hakangoktug-torun/ELE495-Autonomous-Basketball-Robot/media/urun_son.jpeg

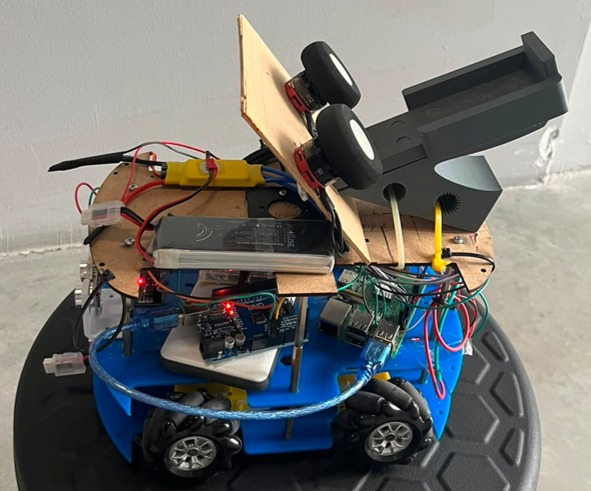
media/urun_son.jpeg
