hakangoktug-torun/ELE495-Autonomous-Basketball-Robot/software/raspberry_pi/kalibrasyon_kodlari/test_surus.py

"""
ELE495 - Test Surusu (KARE rota)
Senaryo:
  1) Bir cisim 30 cm'ye kadar yaklasana kadar duz git (1. kenar)
  2) 90 derece sola don (kapali dongu, BNO055 ile)
  3) Bir cisim 30 cm'ye kadar yaklasana kadar duz git (2. kenar)
  4) 90 derece sola don
  5) Bir cisim 30 cm'ye kadar yaklasana kadar duz git (3. kenar)
  6) 90 derece sola don
  7) Bir cisim 30 cm'ye kadar yaklasana kadar duz git (4. kenar)
  8) 90 derece sola don (kareyi tamamlar, robot baslangictaki yone bakar)
  9) Dur

Toplam: 4 kenar + 4 donus = tam bir kare rota, 360 derece toplam donus.

GUNCELLEME (acil durdur destegi): guvenli_donus(), ileri_git_sabit_mesafe()
ve ileri_git_engel_bulunca() artik opsiyonel bir dur_bayragi (threading.Event)
parametresi aliyor. Set edilirse motoru en kisa surede durdurup fonksiyondan
cikarlar - Acil Durdur / Ctrl+C icin kullanilir.

GUNCELLEME (BU SURUM - "hayalet mesafe sicramasi" duzeltmesi):
  ileri_git_engel_bulunca()'da fiziksel olarak IMKANSIZ ani mesafe
  dususleri (orn. 66cm -> 23cm tek ornekte, iki ornek arasindaki ~30-50ms'de
  robotun bu hizda asla kat edemeyecegi bir mesafe) artik dogrudan kabul
  edilmiyor. Bu, ultrasonik sensorun acili yuzeyden/gurultuden kaynakli
  YANLIS bir yankiyi (multipath) GERCEK bir yaklasma sanip, robotu hedeften
  onemli olcude ONCE durdurmasina yol aciyordu (gozlemlendi: hedef 49cm,
  robot 25cm'de durdu). Su an bir sicrama sadece BIR SONRAKI ornek de
  benzer bir deger verirse (yani robot gercekten oraya ulasmissa) kabul
  ediliyor - aksi halde tamamen yoksayilip bir sonraki gercek olcum
  beklenir (bkz. donus_hassas.py'deki HeadingTakip sicrama filtresiyle
  AYNI mantik, burada mesafe icin uygulandi).

Bu dosyayi ayni klasore koy: software/raspberry_pi/kalibrasyon_kodlari/
(donus_kapali_dongu.py ve robot_bridge.py ile ayni yerde olmali)

ONEMLI VARSAYIM: Duz ileri gitme icin motor yon pinlerini tahmin ederek yazdim
(IN1=HIGH,IN2=LOW ve IN3=HIGH,IN4=LOW seklinde - donus kodundaki 'her iki motor
ayni sinyali alir' mantigina ters, cunku duz gitmede motorlar TERS yonde
komutlanmali - fiziksel montaj karsilikli oldugu icin). Eger robot ilk testte
GERI giderse, ILERI_IN_PATTERN degiskenini asagida ters cevir.
"""

import sys
import os
import time
import RPi.GPIO as GPIO

sys.path.append(os.path.join(os.path.dirname(__file__), ".."))
from robot_bridge import RobotBridge
from donus_kapali_dongu import (
    donus_yap, motorlari_ayarla, motorlari_durdur, aci_farki, isinma_yap,
    IN1, IN2, IN3, IN4, ENA, ENB, SERIAL_PORT
)

# ---------- Duz gitme kapali dongu duzeltme ayarlari ----------
DUZELTME_KAZANCI = 0.4    # (P) derece basina duty duzeltme miktari
DUZELTME_KAZANCI_I = 0.03  # (I) kalici/sabit asimetriyi (motor farki) zamanla sifirlamak icin
                             # (0.08'den 0.03'e dusuruldu - integral terimi hatayi zamanla
                             # biriktirip asiri duzeltmeye/erken rota kaymasina yol acabiliyordu)
MAKS_DUZELTME = 10.0      # duty cinsinden - toplam (P+I) duzeltmenin ustsiniri
MAKS_INTEGRAL = 15.0      # integral birikiminin kendi ustsiniri (anti-windup)

# ---------- Duz gitme hiz/kalibrasyon ayarlari ----------
# GUNCELLEME: 6V motor / 11.1V (3S) pil uyumsuzlugu nedeniyle dusuk duty'lerde
# motorlar marjinal/yetersiz tork bolgesinde kaliyordu - rastgele teker
# tutuklugunun asil sebebiydi. Atici (ESC+ucus motorlari) eklenince ek yuk/
# elektriksel gurultu bindigi icin tekerler yine bazen yetersiz kalip stall'a
# girmeye basladi - 1.2x yetersiz kaldigi icin 1.4x'e, sonra sag donuste asma/
# sag arka teker tutuklugu devam ettigi icin 1.5x'e cikarildi.
# ONEMLI: CM_PER_SANIYE artik hafifce GECERSIZ olabilir - hiz degistigi icin
# yeniden kalibre edilmesi gerekebilir (ileri_git_sabit_mesafe kullanan yerlerde).
SOL_HIZ = 38
SAG_HIZ = 42
CM_PER_SANIYE = 23.5  # UYARI: bu deger eski hiz icin kalibre edilmisti, hafif hatali olabilir

ENGEL_ESIGI_CM = 30.0     # bu mesafenin altina inince dur

# Vcc (5V hatti gerilimi) takibi - guc yetersizligi teshisi icin. Test
# boyunca gorulen en dusuk degeri saklar, sonunda ozet olarak yazdirilir.
VCC_TAKIP = {"en_dusuk": None, "dusuk_gerilim_esigi": 4300, "uyari_verildi": False}


def _durdurma_istendi_mi(dur_bayragi):
    """Ortak yardimci - dur_bayragi verilmis ve set edilmisse True doner."""
    return dur_bayragi is not None and dur_bayragi.is_set()


def vcc_kontrol_et(vcc_mv):
    """Vcc degerini VCC_TAKIP'e kaydeder, dusuk gerilimde bir kez uyarir."""
    if vcc_mv is None:
        return
    if VCC_TAKIP["en_dusuk"] is None or vcc_mv < VCC_TAKIP["en_dusuk"]:
        VCC_TAKIP["en_dusuk"] = vcc_mv
    if vcc_mv < VCC_TAKIP["dusuk_gerilim_esigi"] and not VCC_TAKIP["uyari_verildi"]:
        print(f"  [UYARI] DUSUK GERILIM tespit edildi: {vcc_mv:.0f}mV "
              f"(esik: {VCC_TAKIP['dusuk_gerilim_esigi']}mV) - guc kaynagi "
              f"yetersiz kalabilir.")
        VCC_TAKIP["uyari_verildi"] = True
YAVASLAMA_MESAFE_FARKI = 22.5  # esige bu kadar cm kala yavasla (1. kademe) (21'den 22.5'e - 1.5x)
HIZ_YAVAS_ENGEL = 33       # 1. kademe yavaslama hizi (31'den 33'e - 1.5x)
COK_YAVAS_MESAFE_FARKI = 7.5   # esige bu kadar cm kala IYICE yavasla (2. kademe) (7'den 7.5'e - 1.5x)
HIZ_COK_YAVAS_ENGEL = 30   # 2. kademe (son yaklasim) hizi (28'den 30'a - 1.5x)
ILERI_ADIM_CM = 20.0      # her iki donusten sonra gidilecek mesafe
MAKS_ENGEL_BEKLEME = 20.0  # saniye - engel hic bulunamazsa guvenlik siniri


def ileri_yon_ayarla():
    """
    VARSAYIM: Duz ileri gitme icin motor pinleri. Donus kodunda (donus_yonu_ayarla)
    'sol' icin IN1=LOW,IN2=HIGH ve IN3=LOW,IN4=HIGH kullanilmisti (ikisi ayni yonde
    komutlanip robotu DONDURUYORDU). Duz gitmek icin motorlarin TERS yonde
    komutlanmasi gerekiyor (fiziksel montaj karsilikli oldugundan), yani:
      Motor A (IN1,IN2): HIGH,LOW
      Motor B (IN3,IN4): LOW,HIGH  <-- Motor A'nin tam tersi

    Eger robot geri giderse ya da donerse, asagidaki iki satiri birbiriyle
    degistirerek dene.
    """
    GPIO.output(IN1, GPIO.HIGH); GPIO.output(IN2, GPIO.LOW)
    GPIO.output(IN3, GPIO.LOW);  GPIO.output(IN4, GPIO.HIGH)


def geri_yon_ayarla():
    """
    YENI: Duz GERIYE gitme icin motor pinleri - ileri_yon_ayarla()'nin
    TAM TERSI (IN pinleri ters cevrilmis). GECISLER listesinde "sure"
    hareket tipine "yon": "geri" eklenince (bkz. ileri_git_sabit_sure'daki
    yon parametresi) bu fonksiyon kullanilir.
    """
    GPIO.output(IN1, GPIO.LOW);  GPIO.output(IN2, GPIO.HIGH)
    GPIO.output(IN3, GPIO.HIGH); GPIO.output(IN4, GPIO.LOW)


def ileri_git_sabit_mesafe(pwm_a, pwm_b, mesafe_cm, bridge=None, dur_bayragi=None):
    """
    Sabit mesafe ileri gider. bridge verilirse, BNO055 heading feedback ile
    sapmayi (saga/sola kayma) anlik olarak duzeltir - bridge verilmezse
    eskisi gibi acik dongu (duzeltmesiz) calisir.

    dur_bayragi: (YENI) set edilirse hareket en kisa surede durdurulup
    fonksiyondan cikilir.
    """
    sure = mesafe_cm / CM_PER_SANIYE
    print(f"Ileri gidiliyor: {mesafe_cm} cm (~{sure:.2f}s)")

    if _durdurma_istendi_mi(dur_bayragi):
        print("DURDURMA sinyali - ileri gitme baslamadan iptal edildi.")
        return

    ileri_yon_ayarla()

    if bridge is None:
        pwm_a.ChangeDutyCycle(SOL_HIZ)
        pwm_b.ChangeDutyCycle(SAG_HIZ)
        baslangic = time.time()
        while time.time() - baslangic < sure:
            if _durdurma_istendi_mi(dur_bayragi):
                print("DURDURMA sinyali - ileri gitme (acik dongu) iptal ediliyor.")
                break
            time.sleep(0.03)
        motorlari_durdur(pwm_a, pwm_b)
        return

    # ---- Kapali dongu: hedef heading'i koru (PI kontrolor) ----
    hedef_heading = bridge.get_heading()
    print(f"  [DEBUG] Hedef heading: {hedef_heading}")
    baslangic = time.time()
    adim_sayaci = 0
    integral = 0.0
    son_zaman = baslangic

    while time.time() - baslangic < sure:
        if _durdurma_istendi_mi(dur_bayragi):
            print("DURDURMA sinyali - ileri gitme (kapali dongu) iptal ediliyor.")
            break

        simdiki_heading = bridge.get_heading()
        simdi = time.time()
        dt = simdi - son_zaman
        son_zaman = simdi

        if simdiki_heading is not None and hedef_heading is not None:
            # Pozitif hata: heading artmis (robot 'sag'a donmus) -> bunu duzeltmek icin
            # sola kivrilmali -> sol tekeri YAVASLAT, sag tekeri HIZLANDIR
            # Negatif hata: heading azalmis (robot 'sol'a donmus) -> tam tersi
            hata = aci_farki(hedef_heading, simdiki_heading)

            integral += hata * dt
            integral = max(-MAKS_INTEGRAL, min(MAKS_INTEGRAL, integral))  # anti-windup

            duzeltme = DUZELTME_KAZANCI * hata + DUZELTME_KAZANCI_I * integral
            duzeltme = max(-MAKS_DUZELTME, min(MAKS_DUZELTME, duzeltme))

            sol_duty = max(0, min(100, SOL_HIZ - duzeltme))
            sag_duty = max(0, min(100, SAG_HIZ + duzeltme))

            pwm_a.ChangeDutyCycle(sol_duty)
            pwm_b.ChangeDutyCycle(sag_duty)
        else:
            sol_duty, sag_duty = SOL_HIZ, SAG_HIZ
            pwm_a.ChangeDutyCycle(SOL_HIZ)
            pwm_b.ChangeDutyCycle(SAG_HIZ)

        if adim_sayaci % 3 == 0:  # her ~150ms'de bir goster, ekrani doldurmasin
            print(f"  [DEBUG] heading={simdiki_heading} sol_duty={sol_duty:.1f} sag_duty={sag_duty:.1f}")
        adim_sayaci += 1

        time.sleep(0.05)

    motorlari_durdur(pwm_a, pwm_b)
    print(f"  [DEBUG] Ileri gitme tamamlandi, toplam {adim_sayaci} adim calisti.")


def ileri_git_engel_bulunca(bridge, pwm_a, pwm_b, esik_cm=ENGEL_ESIGI_CM,
                              maks_sure=MAKS_ENGEL_BEKLEME, dur_bayragi=None,
                              hiz_carpani=1.0):
    """
    Bir cisim esik_cm mesafesine kadar yaklasana kadar duz gider.
    Esige iki kademeli yavaslama uygulanir (once YAVASLAMA_MESAFE_FARKI,
    sonra COK_YAVAS_MESAFE_FARKI kala) - boylece durma ani daha hassas olur,
    overshoot (esigi fazla gecme) azalir. Ayrica BNO055 heading feedback ile
    saga/sola kaymayi (drift) anlik olarak duzeltir.

    hiz_carpani: (YENI) taban hizi (SOL_HIZ/SAG_HIZ) bu katsayiyla carpar -
    SADECE bu cagriya ozel, global SOL_HIZ/SAG_HIZ SABIT kalir (diger
    kullanimlari etkilemez). Ornegin hiz_carpani=1.3/1.5 ile, global
    hizlar 1.5x kalibrasyonuna gore ayarlanmisken bu YOL ozelinde 1.3x'e
    dusurulmus olur. 1.0 = degisiklik yok (varsayilan).

    dur_bayragi: (YENI) set edilirse hareket en kisa surede durdurulup
    False donulur (engel bulunamamis gibi - cagiran kod zaten bunu guvenli
    bir durus olarak isliyor).

    ONEMLI: Ultrasonik sensor (HC-SR04) acili yuzeylerden/duvar koselerinden
    yansiyinca (multipath) tek seferlik, gercek olmayan yakin mesafe okumalari
    verebilir. Bunu filtrelemek icin iki AYRI mekanizma var:
      1) Sadece GERCEKTEN YENI gelen Arduino orneklerini sayiyoruz (bridge'in
         ic 'last_update' zaman damgasina bakarak) - ayni bayat degeri hizli
         polling yuzunden birden fazla kez okumus olmak, "dogrulanmis ardisik
         okuma" sayilmiyor.
      2) (YENI) FIZIKSEL OLABILIRLIK FILTRESI: iki ornek arasinda robotun bu
         hizda ASLA kat edemeyecegi kadar BUYUK ve ANI bir mesafe DUSUSU
         (orn. 66cm -> 23cm tek ornekte) dogrudan kabul edilmez - byle bir
         sicrama, BIR SONRAKI ornek de benzer bir deger vermezse tamamen
         yoksayilir (donus_hassas.py'deki heading sicrama filtresiyle AYNI
         mantik, burada mesafe icin). Bu, sensorun yanlis/erken bir yankiyi
         gercek bir yaklasma sanip robotu hedeften COK ONCE durdurmasini
         (gozlemlenen bir sorun) engeller.
    """
    print(f"Engel araniyor (esik: {esik_cm} cm, hiz carpani: {hiz_carpani:.3f})...")

    if _durdurma_istendi_mi(dur_bayragi):
        print("DURDURMA sinyali - engel aramaya baslamadan iptal edildi.")
        return False

    ileri_yon_ayarla()

    hedef_heading = bridge.get_heading()  # duz gitmeyi korumak icin referans yon

    temel_sol, temel_sag = SOL_HIZ * hiz_carpani, SAG_HIZ * hiz_carpani
    pwm_a.ChangeDutyCycle(temel_sol)
    pwm_b.ChangeDutyCycle(temel_sag)

    yavas_moda_gecildi = False
    cok_yavas_moda_gecildi = False
    ardisik_esik_alti = 0
    GEREKEN_ARDISIK_OKUMA = 3
    son_islenen_zaman_damgasi = None
    integral = 0.0
    son_zaman = time.time()

    # STALL tespiti: yavaslama asamasinda mesafe uzun sure hic degismezse,
    # robot dusuk duty'de fiziksel olarak durmus (stall) demektir - donus
    # testlerinde ayni sorunu yasamistik. Boyle bir durumda kisa bir sure
    # icin tam hiza cikip 'kurtarma' (unstick) yapariz.
    STALL_ESIGI = 1.0  # saniye - mesafe bu sure degismezse stall say (artik tum hiz modlarinda)
    KURTARMA_SURESI = 0.15  # saniye - kurtarma icin tam hizda kalinacak sure
    MAKS_ARDISIK_KURTARMA = 5  # bu kadar ardisik kurtarma basarisiz olursa vazgec, guvenlik amacli dur
    ardisik_basarisiz_kurtarma = 0
    son_mesafe_degeri = None
    son_mesafe_degisim_zamani = time.time()

    # ---- YENI: Fiziksel olabilirlik filtresi (multipath/gurultu korumasi) ----
    # son_gecerli_mesafe: en son KABUL EDILEN (gercek sayilan) mesafe olcumu.
    # bekleyen_supheli_mesafe: suphelenilen ama henuz DOGRULANMAMIS bir
    #   sicrama degeri - bir sonraki ornek buna yakin cikarsa gercek sayilir.
    # MAKS_GECERLI_MESAFE_SICRAMASI: bir ornekten digerine (yaklasik 30-50ms
    #   arayla) bu kadar cm'den BUYUK bir ANI DUSUS, robotun bu hizda
    #   fiziksel olarak kat edemeyecegi bir mesafedir - supheli sayilir.
    son_gecerli_mesafe = None
    bekleyen_supheli_mesafe = None
    MAKS_GECERLI_MESAFE_SICRAMASI = 15.0  # cm

    baslangic = time.time()
    while time.time() - baslangic < maks_sure:
        if _durdurma_istendi_mi(dur_bayragi):
            motorlari_durdur(pwm_a, pwm_b)
            print("DURDURMA sinyali - engel arama dongusu iptal ediliyor.")
            return False

        if bridge.is_stale(max_age_sec=0.5):
            time.sleep(0.03)
            continue

        veri = bridge.get_all()
        mesafe = veri["distance"]
        simdiki_heading = veri["heading"]
        guncel_zaman_damgasi = veri["last_update"]

        simdi = time.time()
        dt = simdi - son_zaman
        son_zaman = simdi

        # ---- Heading feedback ile saga/sola kaymayi duzelt (PI kontrolor) ----
        if simdiki_heading is not None and hedef_heading is not None:
            hata = aci_farki(hedef_heading, simdiki_heading)

            integral += hata * dt
            integral = max(-MAKS_INTEGRAL, min(MAKS_INTEGRAL, integral))  # anti-windup

            duzeltme = DUZELTME_KAZANCI * hata + DUZELTME_KAZANCI_I * integral
            duzeltme = max(-MAKS_DUZELTME, min(MAKS_DUZELTME, duzeltme))
        else:
            duzeltme = 0.0

        sol_duty = max(0, min(100, temel_sol - duzeltme))
        sag_duty = max(0, min(100, temel_sag + duzeltme))
        pwm_a.ChangeDutyCycle(sol_duty)
        pwm_b.ChangeDutyCycle(sag_duty)

        # Bu, bir onceki kontrolden beri gelen GERCEKTEN YENI bir ornek mi?
        yeni_ornek_mi = (son_islenen_zaman_damgasi is None or
                         guncel_zaman_damgasi != son_islenen_zaman_damgasi)

        if yeni_ornek_mi and mesafe is not None and mesafe > 0:  # -1 = gecersiz okuma, yoksay
            son_islenen_zaman_damgasi = guncel_zaman_damgasi

            # ---- Fiziksel olabilirlik filtresi (multipath/gurultu korumasi) ----
            # Ani ve BUYUK bir mesafe dususu (orn. 66cm -> 23cm tek ornekte),
            # robotun bu hizda fiziksel olarak kat edemeyecegi bir degisimdir.
            # Boyle bir sicrama, bir SONRAKI ornekte DE benzer bir deger
            # vermezse GERCEK sayilmaz ve tamamen yoksayilir.
            if (son_gecerli_mesafe is not None and
                    (son_gecerli_mesafe - mesafe) > MAKS_GECERLI_MESAFE_SICRAMASI):
                if bekleyen_supheli_mesafe is not None and abs(mesafe - bekleyen_supheli_mesafe) <= 3.0:
                    print(f"  (Mesafe sicramasi DOGRULANDI, gercek kabul edildi: {mesafe:.1f} cm)")
                    bekleyen_supheli_mesafe = None
                else:
                    print(f"  (SUPHELI mesafe sicramasi gorzmezden gelindi: "
                          f"{son_gecerli_mesafe:.1f}cm -> {mesafe:.1f}cm - "
                          f"bir sonraki ornekte dogrulanirsa kabul edilecek)")
                    bekleyen_supheli_mesafe = mesafe
                    time.sleep(0.03)
                    continue
            son_gecerli_mesafe = mesafe

            print(f"  Mesafe: {mesafe:.1f} cm")
            vcc_kontrol_et(veri.get("vcc_mv"))

            # STALL tespiti: HANGI hiz modunda olursa olsun (tam hiz dahil),
            # mesafe STALL_ESIGI suresi boyunca hic degismediyse, robot
            # fiziksel olarak durmus demektir. Kisa bir 'kurtarma' atisi yap.
            # ONCEKI SURUM sadece yavas modlarda kontrol ediyordu - bu da tam
            # hizdayken olusan tam stall'lari (hicbir tekerin donmedigi durum)
            # kacirmasina yol aciyordu.
            if son_mesafe_degeri is None or abs(mesafe - son_mesafe_degeri) >= 1.0:
                son_mesafe_degeri = mesafe
                son_mesafe_degisim_zamani = time.time()
                ardisik_basarisiz_kurtarma = 0
            elif (time.time() - son_mesafe_degisim_zamani > STALL_ESIGI and
                  mesafe > esik_cm):
                ardisik_basarisiz_kurtarma += 1
                print(f"  (STALL tespit edildi - {mesafe:.1f} cm'de takili kaldi, "
                      f"kurtarma atisi yapiliyor... [{ardisik_basarisiz_kurtarma}/{MAKS_ARDISIK_KURTARMA}])")

                if ardisik_basarisiz_kurtarma > MAKS_ARDISIK_KURTARMA:
                    print(f"  HATA: {MAKS_ARDISIK_KURTARMA} kurtarma denemesi de basarisiz oldu - "
                          f"robot gercekten hareket etmiyor. Muhtemelen fiziksel bir baglanti "
                          f"sorunu (motor/kablo/L298N). Guvenlik amacli durduruluyor.")
                    motorlari_durdur(pwm_a, pwm_b)
                    return False

                # GUNCELLEME: Son yaklasim fazinda (cok_yavas_moda_gecildi)
                # TAM HIZLI kurtarma atisi (SOL_HIZ/SAG_HIZ) tehlikeli -
                # hedefe cok yakinken ani bir tam-hiz sicramasi, mesafeyi
                # gercekte 'takilma' olmadigi halde ciddi olcude asirabilir
                # (overshoot). Bu asamada zaten dogal olarak cok yavas/az
                # hareket beklenir - bu yuzden daha hafif bir kurtarma
                # (HIZ_YAVAS_ENGEL, daha kisa sure) kullaniyoruz. Sadece
                # hala uzaktayken (henuz cok_yavas_moda_gecildi degilken)
                # gercekten guclu bir "unstick" gerekebilir - orada eskisi
                # gibi tam hiz kullanilmaya devam ediyor.
                if cok_yavas_moda_gecildi:
                    kurtarma_sol, kurtarma_sag = HIZ_YAVAS_ENGEL, HIZ_YAVAS_ENGEL + (SAG_HIZ - SOL_HIZ)
                    kurtarma_suresi_efektif = KURTARMA_SURESI * 0.5
                else:
                    kurtarma_sol, kurtarma_sag = SOL_HIZ * hiz_carpani, SAG_HIZ * hiz_carpani
                    kurtarma_suresi_efektif = KURTARMA_SURESI

                pwm_a.ChangeDutyCycle(kurtarma_sol)
                pwm_b.ChangeDutyCycle(kurtarma_sag)
                time.sleep(kurtarma_suresi_efektif)
                # Kurtarma sonrasi kaldigi yavaslama moduna geri don
                pwm_a.ChangeDutyCycle(temel_sol)
                pwm_b.ChangeDutyCycle(temel_sag)
                son_mesafe_degisim_zamani = time.time()  # sayaci sifirla


            # 2. kademe: esige iyice yaklasinca daha da yavasla (once kontrol
            # edilmeli, cunku 2. kademe esigi 1. kademe esiginin icinde kalir)
            if not cok_yavas_moda_gecildi and mesafe <= (esik_cm + COK_YAVAS_MESAFE_FARKI):
                temel_sol, temel_sag = HIZ_COK_YAVAS_ENGEL, HIZ_COK_YAVAS_ENGEL + (SAG_HIZ - SOL_HIZ)
                cok_yavas_moda_gecildi = True
                yavas_moda_gecildi = True  # 1. kademeyi de gecmis sayilir
                print(f"  (Son yaklasim - iyice yavaslandi: {mesafe:.1f} cm)")
            # 1. kademe: esige yaklasinca yavasla
            elif not yavas_moda_gecildi and mesafe <= (esik_cm + YAVASLAMA_MESAFE_FARKI):
                temel_sol, temel_sag = HIZ_YAVAS_ENGEL, HIZ_YAVAS_ENGEL + (SAG_HIZ - SOL_HIZ)
                yavas_moda_gecildi = True
                print(f"  (Yavaslama bolgesine girildi: {mesafe:.1f} cm)")

            if mesafe <= esik_cm:
                ardisik_esik_alti += 1
                if ardisik_esik_alti >= GEREKEN_ARDISIK_OKUMA:
                    motorlari_durdur(pwm_a, pwm_b)
                    print(f"Engel tespit edildi ({mesafe:.1f} cm), duruldu.")
                    return True
            else:
                ardisik_esik_alti = 0

        time.sleep(0.03)  # daha sik ornekleme, tepki suresini kisaltir

    motorlari_durdur(pwm_a, pwm_b)
    print("UYARI: Zaman asimi, engel bulunamadi. Guvenlik amacli durduruldu.")
    return False


def guvenli_donus(hedef_derece, yon, bridge, pwm_a, pwm_b, maks_deneme=2, dur_bayragi=None):
    """
    donus_yap()'i cagirir, ama sonucu KONTROL EDER. Eger donus BNO055
    kilitlenmesi ya da baska bir sorun yuzunden basarisiz olduysa (donen
    aci, hedefin cok altindaysa - orn. yarisindan az), bunu sessizce
    gecmez: uyari basar ve tekrar dener. Tum denemeler basarisiz olursa,
    False donup testin guvenli sekilde durmasini saglar.

    dur_bayragi: (YENI) set edilirse HICBIR tekrar denemesi yapilmadan
    hemen False doner (donus_yap zaten mevcut donusu de aninda iptal eder).

    Donus deger: True (basarili) / False (tum denemeler basarisiz)
    """
    for deneme in range(1, maks_deneme + 1):
        if _durdurma_istendi_mi(dur_bayragi):
            print("DURDURMA sinyali - donus denemesi yapilmadan iptal edildi.")
            return False

        sonuc = donus_yap(hedef_derece, yon=yon, bridge=bridge, pwm_a=pwm_a, pwm_b=pwm_b,
                           otonom=True, dur_bayragi=dur_bayragi)

        # Basari kontrolu: donen aci, hedefin en az yarisi kadar olmali.
        # Kilitlenme durumunda donus_yap 0.0 (ya da cok kucuk bir deger) doner.
        if abs(sonuc) >= hedef_derece * 0.5:
            return True

        if _durdurma_istendi_mi(dur_bayragi):
            # Basarisizlik durdurma sinyalinden kaynaklandi - tekrar denemeye gerek yok
            return False

        print(f"\nUYARI: Donus basarisiz gorunuyor (istenen {hedef_derece}, "
              f"gerceklesen {sonuc:.1f}). Deneme {deneme}/{maks_deneme}.")

        if deneme < maks_deneme:
            print("Tekrar deneniyor...\n")
            time.sleep(1.0)  # sensorun toparlanmasi icin kisa bir bekleme

    print(f"\nHATA: {maks_deneme} denemede de donus basarili olamadi. "
          f"Test guvenlik amacli durduruluyor.")
    print("Onerilen adimlar: BNO055 baglantisini/montajini kontrol et, "
          "titresim/EMI kaynaklarini gozden gecir.")
    return False


def kucuk_aci_test_ve_ana_donus(bridge, pwm_a, pwm_b, hedef_no, kucuk_aci=20.0, ana_aci=90.0):
    """
    Once KUCUK bir aci testi yapar (saga kucuk_aci kadar don, sonra ayni
    miktarda sola geri don - yani net olarak yerinde kalmasi beklenir),
    sonra normal ANA donusu (sola ana_aci) yapar.

    Bu, kucuk acili donuslerin (ozellikle 'tek/iki teker dönmeme' sorununun
    kucuk acilarda da yasanip yasanmadigini) test etmek icin eklendi.

    Donus deger: True (hepsi basarili) / False (herhangi biri basarisiz)
    """
    print(f"\n=== {hedef_no}. HEDEF - KUCUK ACI TESTI ===")
    print(f"Once saga {kucuk_aci} derece donuluyor (test)...")
    if not guvenli_donus(kucuk_aci, "sag", bridge, pwm_a, pwm_b):
        print(f"Kucuk aci testi (saga {kucuk_aci} derece) basarisiz oldu.")
        return False

    print(f"Simdi sola {kucuk_aci} derece donup baslangic yonune donuluyor...")
    if not guvenli_donus(kucuk_aci, "sol", bridge, pwm_a, pwm_b):
        print(f"Kucuk aci testi (geri donus, sola {kucuk_aci} derece) basarisiz oldu.")
        return False

    print(f"\n=== {hedef_no}. DONUS: {ana_aci} derece sola (ana donus) ===")
    if not guvenli_donus(ana_aci, "sol", bridge, pwm_a, pwm_b):
        print(f"{hedef_no}. ana donus basarisiz oldu.")
        return False

    return True


def main():
    bridge = RobotBridge(port=SERIAL_PORT)
    bridge.start()

    print("BNO055/RobotBridge baglantisi bekleniyor...")
    for _ in range(50):
        if not bridge.is_stale(max_age_sec=1.0):
            break
        time.sleep(0.1)

    if bridge.is_stale(max_age_sec=1.0):
        print("UYARI: Sensor veri akisi yok, baglantiyi kontrol et.")
        bridge.stop()
        return

    # HIZLI MOD: renk sensoru okumasini bastan kapatiyoruz - bu, hem
    # donuslerde hem duz gitmede (mesafe durma kararinda) heading/mesafe
    # verisinin cok daha guncel gelmesini saglar. Bu test scriptinde renk
    # verisi zaten kullanilmiyor.
    bridge.request_fast_mode()
    time.sleep(0.1)

    # PWM nesnelerini BIR KEZ olustur, tum test boyunca (donus + duz gitme)
    # ayni nesneleri kullan. RPi.GPIO'nun ayni pinde ust uste PWM
    # olusturma/yikma sirasinda bazen motoru tepkisiz birakmasi sorununu onler.
    pwm_a, pwm_b = motorlari_ayarla()

    # NOT: Otomatik isinma hareketi (kucuk sallanma) KALDIRILDI. EEPROM'dan
    # kalibrasyon zaten yukleniyor ve hizli mod (renk sensoru kapali) veri
    # kalitesini onemli olcude arttirdigi icin, bu hareketin sagladigi kucuk
    # fayda (mag kalibrasyonuna hafif katki), robotun baslangic yonunde
    # istenmeyen kaymaya yol acma riskine degmiyor. Gerekirse yeniden
    # aktiflestirmek icin: isinma_yap(bridge, pwm_a, pwm_b)

    try:
        # ---- 1) Engele kadar duz git ----
        bulundu = ileri_git_engel_bulunca(bridge, pwm_a, pwm_b)

        if not bulundu:
            print("Engel bulunamadigi icin test durduruldu.")
            return

        # ---- 2) Kucuk aci testi + 90 derece sola don ----
        if not kucuk_aci_test_ve_ana_donus(bridge, pwm_a, pwm_b, 1):
            print("Test durduruldu (1. hedefteki donusler basarisiz).")
            return

        # ---- 3) Engele (30 cm) kadar duz git ----
        bulundu = ileri_git_engel_bulunca(bridge, pwm_a, pwm_b)
        if not bulundu:
            print("Engel bulunamadigi icin test durduruldu.")
            return

        # ---- 4) Kucuk aci testi + 90 derece sola don ----
        if not kucuk_aci_test_ve_ana_donus(bridge, pwm_a, pwm_b, 2):
            print("Test durduruldu (2. hedefteki donusler basarisiz).")
            return

        # ---- 5) Engele (30 cm) kadar duz git ----
        bulundu = ileri_git_engel_bulunca(bridge, pwm_a, pwm_b)
        if not bulundu:
            print("Engel bulunamadigi icin test durduruldu.")
            return

        # ---- 6) Kucuk aci testi + 90 derece sola don ----
        if not kucuk_aci_test_ve_ana_donus(bridge, pwm_a, pwm_b, 3):
            print("Test durduruldu (3. hedefteki donusler basarisiz).")
            return

        # ---- 7) Engele (30 cm) kadar duz git (4. kenar) ----
        bulundu = ileri_git_engel_bulunca(bridge, pwm_a, pwm_b)
        if not bulundu:
            print("Engel bulunamadigi icin test durduruldu.")
            return

        # ---- 8) Kucuk aci testi + son 90 derece sola don (kareyi tamamla) ----
        if not kucuk_aci_test_ve_ana_donus(bridge, pwm_a, pwm_b, 4):
            print("Test durduruldu (4. hedefteki donusler basarisiz).")
            return

        print("\nTest surusu tamamlandi (kare tamamlandi - toplam 4 kenar, 4 ana donus, "
              "her hedefte ek kucuk aci testi).")

    finally:
        motorlari_durdur(pwm_a, pwm_b)
        pwm_a.stop()
        pwm_b.stop()
        GPIO.cleanup()
        if VCC_TAKIP["en_dusuk"] is not None:
            print(f"\n[VCC OZETI] Test boyunca gorulen en dusuk gerilim: "
                  f"{VCC_TAKIP['en_dusuk']:.0f} mV")
        bridge.stop()


if __name__ == "__main__":
    main()
