hakangoktug-torun/ELE495-Autonomous-Basketball-Robot/software/raspberry_pi/kalibrasyon_kodlari/donus_test_sola_180.py

"""
ELE495 - Tek basina donus testi: 180 derece SOLA
Bu dosyayi kalibrasyon_kodlari/ klasorune koy, donus_kapali_dongu.py ile ayni yerde olmali.

Kullanim:
    python3 donus_test_sola_180.py
"""

from donus_kapali_dongu import donus_yap

if __name__ == "__main__":
    donus_yap(180, yon="sol")
