hakangoktug-torun/ELE495-Autonomous-Basketball-Robot/(commit log)

2026-06-13 arduino ilk deneme kodu
    rs2205 2300kv brushless motor kontrol arduino kodu
2026-06-17 Add files via upload
    E18-D80NK IR arduino basit deneme testi
2026-06-23 Add Raspberry Pi robot control scaffold
2026-06-24 arduino uno is added
2026-07-03 Add Raspberry Pi GPIO test script for L298N motor
    This script tests the L298N motor driver with Raspberry Pi GPIO by moving the motors forward at a low speed for a short duration.
2026-07-11 11 temmuz gelismeleri 2. etap, hiz aynı kaldi, stall riski devam ediyor
    [donus_kapali_dongu.py, interaktif_kare_test.py, robot_bridge.py, voltaj_izle.py]
2026-07-12 12 temmuz gelismeleri 2. etap: hiz 1.2'ye cekildi, stall riski yok
2026-07-12 12 temmuz gelismeleri 3. etap: hiz 1.2'ye cekildi, stall riski yok, ozel rota hazirlandi
2026-07-25 Revise and expand hardware documentation
    Expanded the hardware documentation to provide detailed information on system components, wiring, safety requirements, and known caveats. Updated the structure and content for better clarity and organization.
2026-07-26 Add real-time robot status panel and classification logic
    Added a new panel to display real-time robot status, including indicators for various states such as waiting, starting, and errors. Updated the logic to classify and show the robot's current activity based on backend status data.
